davidkerny/Stadi_Speedo/PCB_Stadi_Speedo_V2/MEGA328PB Pinouttt.png

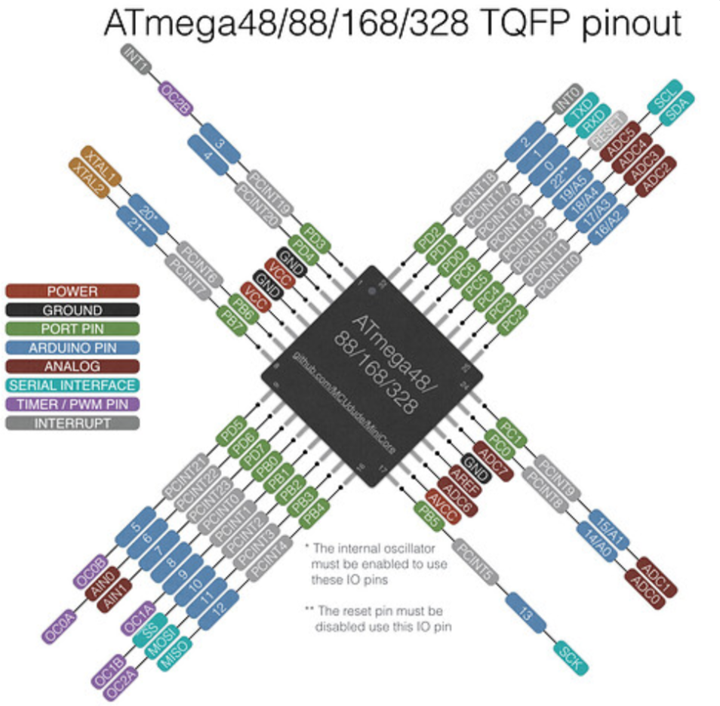
PCB_Stadi_Speedo_V2/MEGA328PB Pinouttt.png
