davidkerny/Stadi_Speedo/PCB_Stadi_Speedo_V2/PCB v2_zaloha 6_10/Screenshot_49.png

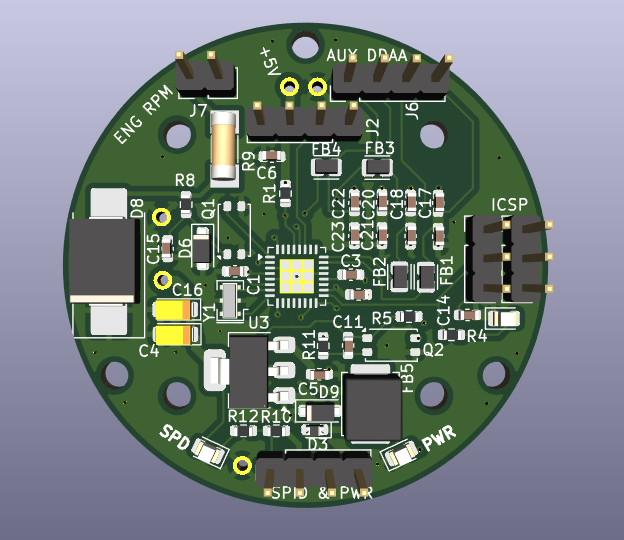
PCB_Stadi_Speedo_V2/PCB v2_zaloha 6_10/Screenshot_49.png
