davidkerny/Stadi_Speedo/README.md

Varianty pro Stadi_Speedo HW board:
__________________________________

MultiGauge od V1.8:

1. SPÍDO režim: (rychloměr) se ukazuje:
   pokud budík zaznamená jízdu.
   Pokud nějaké zaznamená, ukáže i celkově ujeté km, trip km, max. km/h, otáčky motoru.
   Při rychlejší jízdě radši skryje zbytečnosti.
3. TACHO režim (otáčkoměr)
   pokud zaznamenává otáčky motoru, ale ještě nikdy "nejel". Rpm + max. rpm.
4. Rev Mode (dočasný otáčkoměr)
   pokud už moped jel a tůruješ ho na místě, ukáže otáčky, max. rpm + trip km.

Historické okénko:
- Tacho V1 vychází ze Speedo V6
- MultiGauge V1 vychází ze Speedo V6 + Tacho V1
- AnaloGauge V1 vychází z MultiGauge V1.3

________________________
Varianty pro Waveshare ESP32-S3 2.1 TOUCH LCD board:

  - WS21 Gauge

_________________________
