davidkerny/Stadi_Speedo/grafika/Screenshot_43.png

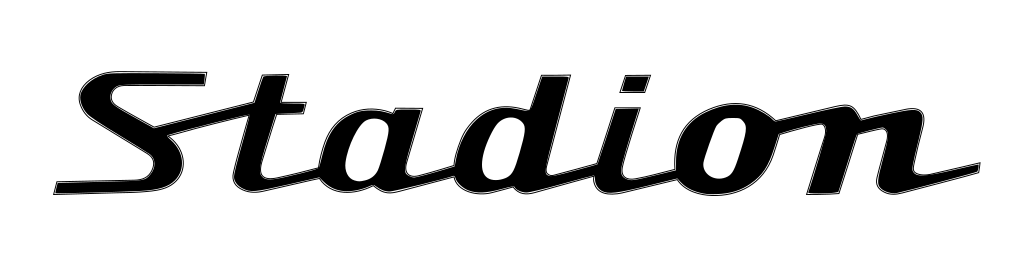
grafika/Screenshot_43.png
