davidkerny/Stadi_Speedo/PCB_AnaloGauge_UniFace/Screenshot_56.png

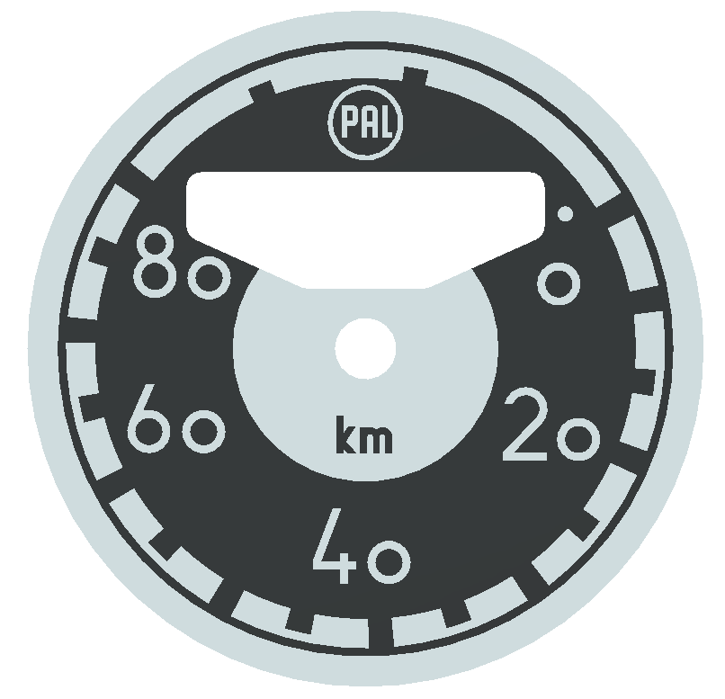
PCB_AnaloGauge_UniFace/Screenshot_56.png
