davidkerny/Stadi_Speedo/PCB_AnaloGauge_UniFace/Screenshot_57.png

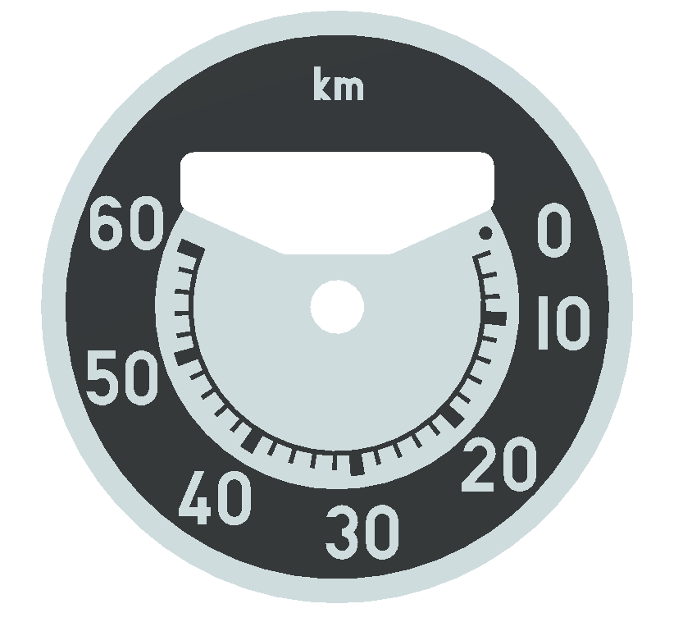
PCB_AnaloGauge_UniFace/Screenshot_57.png
