davidkerny/Stadi_Speedo/PCB_AnaloGauge_UniFace/Screenshot_58.png

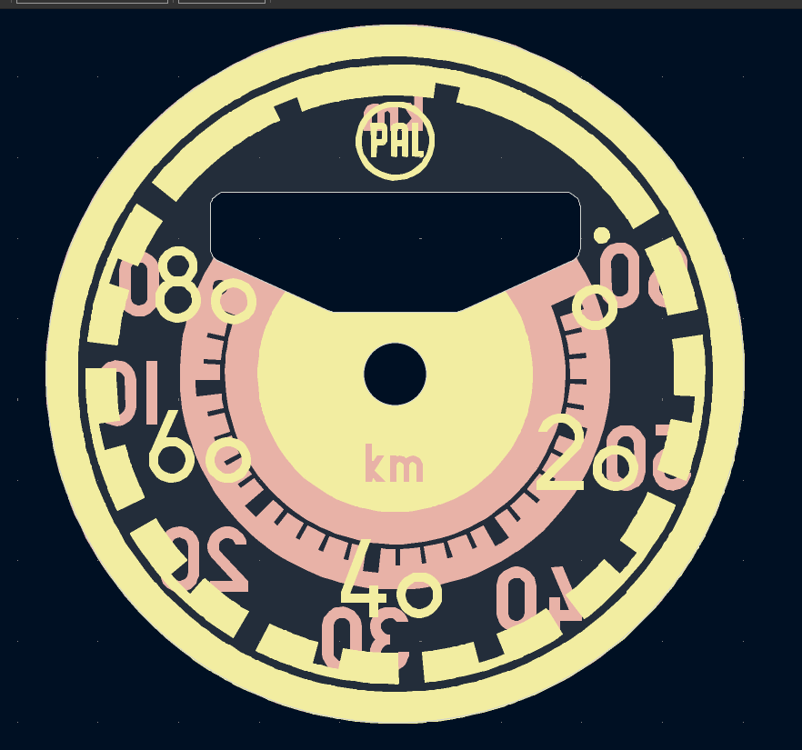
PCB_AnaloGauge_UniFace/Screenshot_58.png
