davidkerny/Stadi_Speedo/PCB_AnaloGauge_UniFace/Screenshot_60.png

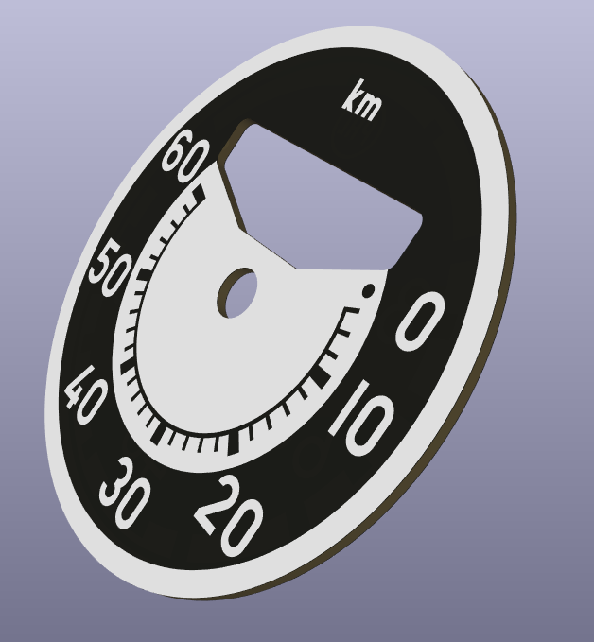
PCB_AnaloGauge_UniFace/Screenshot_60.png
