davidkerny/Stadi_Speedo/PCB_Stadi_Speedo_V2/Screenshot_57.png

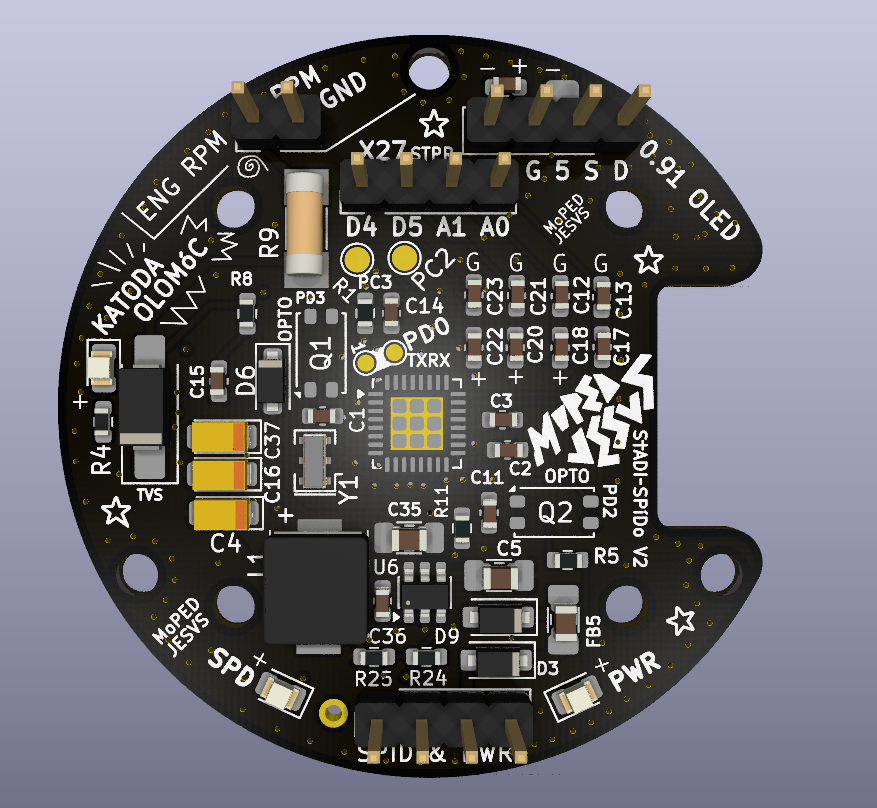
PCB_Stadi_Speedo_V2/Screenshot_57.png
