davidkerny/Stadi_Speedo/PCB_Stadi_Speedo_V2/Screenshot_58.png

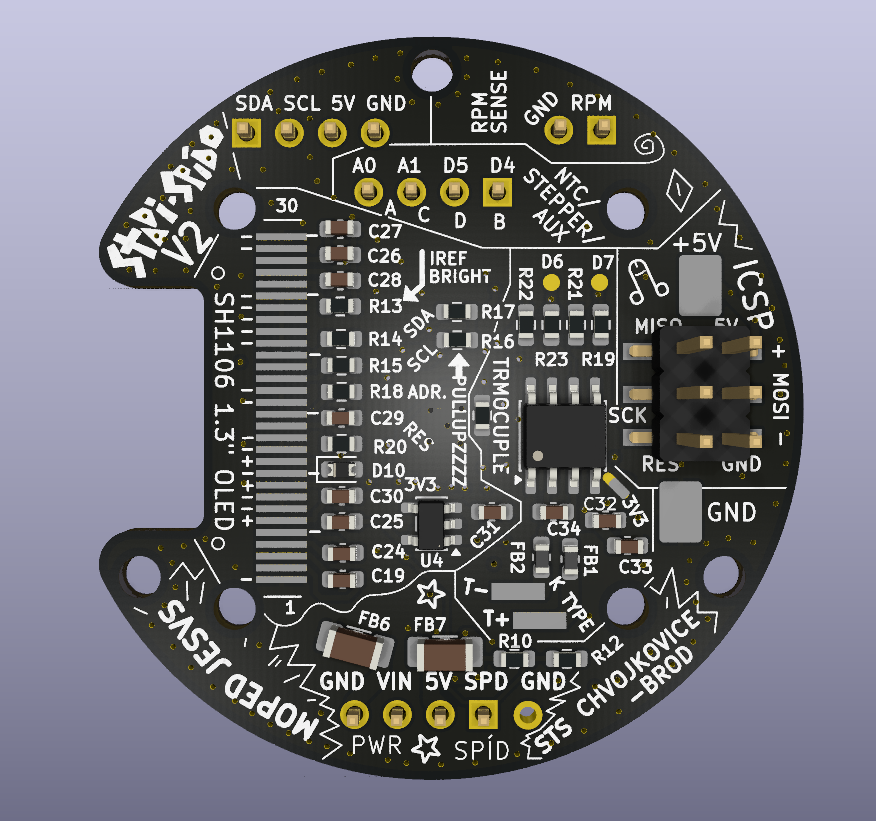
PCB_Stadi_Speedo_V2/Screenshot_58.png
