davidkerny/Stadi_Speedo/PCB_Stadi_Speedo_V2/webench lmr51610.png

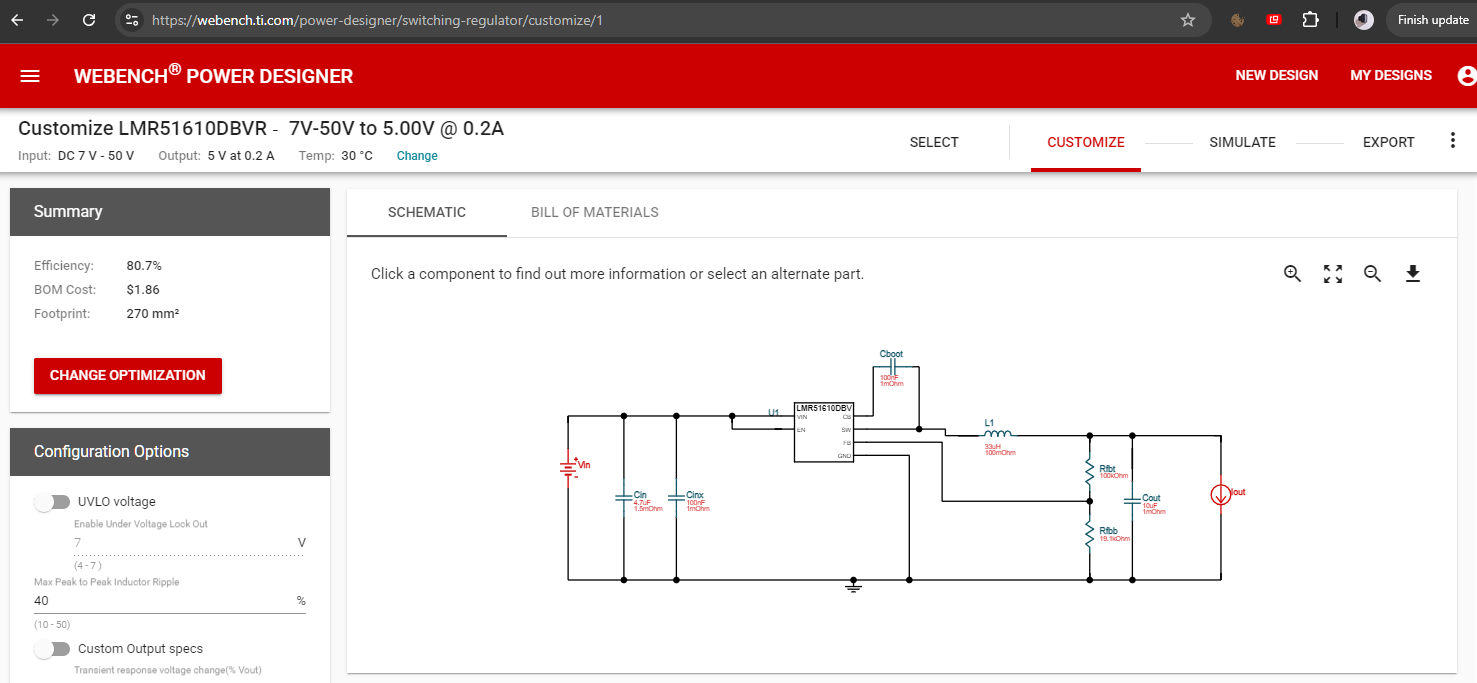
PCB_Stadi_Speedo_V2/webench lmr51610.png
