davidkerny/Stadi_Speedo/PCB_Stadi_Speedo_V2/bom/Stadi_Speedo_V2.csv

Id | Designator | Footprint | Quantity | Designation | Supplier and ref
1 | , , , , , , , , , , |  | 11
2 | C1, C2, C6, C19, C24, C25, C30, C31, C33 | C_0603_1608Metric | 9 | 1u
3 | C3, C11, C12, C13, C14, C17, C18, C20, C21, C22, C23, C29, C32, C34, C36 | C_0603_1608Metric | 15 | 100n
4 | C4, C16, C37 | CP_EIA-3216-10_Kemet-I | 3 | 4u7_16V
5 | C5 | C_0603-1206_universal_Pad1.18x1.45mm | 1 | 4u7
6 | C15 | C_0603_1608Metric | 1 | 10n
7 | C26, C27 | C_0603_1608Metric | 2 | 2.2u
8 | C28 | C_0603_1608Metric | 1 | 4.7u
9 | C35 | C_0603-1206_universal_Pad1.18x1.45mm | 1 | 4u7_16V
10 | D1, D7 | LED_0805_2012Metric | 2 | Yellow
11 | D2 | LED_0805_2012Metric | 1 | Green
12 | D3 | D_SOD-123FL | 1 | D_Small
13 | D6 | D_SOD-123F | 1 | 1N4148W
14 | D8 | D_SMA_Handsoldering | 1 | SMCJ85CA
15 | D9 | D_SOD-123FL | 1 | PTVS8V5S1UTR-QX
16 | D10 | D_0603_1608Metric | 1 | D_Small
17 | FB1, FB2 | L_0603_1608Metric | 2 | FerriteBead_Small
18 | FB5 | C_0603-1206_universal_Pad1.18x1.45mm | 1 | FerriteBead_4A_180Ω
19 | FB6, FB7 | C_0603-1206_universal_Pad1.33x1.80mm_HandSolder | 2 | FerriteBead_4A_180Ω
20 | J2 | PinHeader_1x04_P2.54mm_Vertical | 1 | OLED I2C
21 | J3 | PinHeader_2x03_P2.54mm_Vertical_SMD | 1 | ICSP
22 | J4 | OLED-128O064D | 1 | OLED SH1106
23 | J5 | PinHeader_1x04_P2.54mm_Vertical | 1 | SPÍD & PWR
24 | J6 | PinHeader_1x04_P2.54mm_Vertical | 1 | AUX DDAA
25 | J7 | PinHeader_1x02_P2.54mm_Vertical | 1 | ENG RPM
26 | L1 | L_Bourns_SRP2313AA | 1 | L_Ferrite
27 | Q1 | Panasonic_APV-AQY_SSOP-4_4.45x2.65mm_P1.27mm | 1 | 140817143200
28 | Q2 | Panasonic_APV-AQY_SSOP-4_4.45x2.65mm_P1.27mm | 1 | PC817
29 | R1, R4, R5, R12 | R_0603_1608Metric | 4 | 1k
30 | R8 | R_0603_1608Metric | 1 | 15k
31 | R9 | R_MELF_MMB-0207 | 1 | 200R
32 | R10 | R_0603_1608Metric | 1 | 10k
33 | R11 | R_0603_1608Metric | 1 | 470R
34 | R13 | R_0603_1608Metric | 1 | 560K (390K)
35 | R14, R15 | R_0603_1608Metric | 2 | 100R
36 | R16, R17, R20 | R_0603_1608Metric | 3 | 10k (4K7)
37 | R18 | R_0603_1608Metric | 1 | 4K7
38 | R19, R23, R23 | R_0603_1608Metric | 3 | 10K
39 | R21, R22 | R_0603_1608Metric | 2 | 20K
40 | R24 | R_0603_1608Metric | 1 | 100k
41 | R25 | R_0603_1608Metric | 1 | 19.1k
42 | U1 | QFN-32-1EP_5x5mm_P0.5mm_EP3.1x3.1mm | 1 | Mikroprofesor
43 | U4 | SOT-23-5 | 1 | ME6211C33M5
44 | U5 | SOIC-8_3.9x4.9mm_P1.27mm | 1 | MAX31855KASA
45 | U6 | SOT-23-6 | 1 | LMR51610YDBVR
46 | Y1 | Resonator_SMD_Murata_CSTxExxV-3Pin_3.0x1.1mm | 1 | 16MHz
