davidkerny/Stadi_Speedo/PCB_Stadi_Speedo_V2/production/Stadi_Speedo_V2_bom.csv

Designator | Footprint | Quantity | Value | LCSC Part #
_11, _10, _9, _8, _7, _6, _5, _4, _3, _2, |  | 11
C1, C19, C2, C24, C25, C30, C31, C33, C6 | 0603 | 9 | 1u
C11, C12, C13, C14, C17, C18, C20, C21, C22, C23, C29, C3, C32, C34, C36 | 0603 | 15 | 100n
C15 | 0603 | 1 | 10n
C16, C37, C4 | CP_EIA-3216-10_Kemet-I | 3 | 4u7_16V
C26, C27 | 0603 | 2 | 2.2u
C28 | 0603 | 1 | 4.7u
C35 | C_0603-1206_universal_Pad1.18x1.45mm | 1 | 4u7_16V
C5 | C_0603-1206_universal_Pad1.18x1.45mm | 1 | 4u7
D1, D7 | 0805 | 2 | Yellow | C2296
D10 | 0603 | 1 | D_Small
D2 | 0805 | 1 | Green | C2297
D3 | D_SOD-123FL | 1 | D_Small
D6 | D_SOD-123F | 1 | 1N4148W
D8 | D_SMA_Handsoldering | 1 | SMCJ85CA
D9 | D_SOD-123FL | 1 | PTVS8V5S1UTR-QX
FB1, FB2 | 0603 | 2 | FerriteBead_Small
FB5 | C_0603-1206_universal_Pad1.18x1.45mm | 1 | FerriteBead_4A_180Ω
FB6, FB7 | C_0603-1206_universal_Pad1.33x1.80mm_HandSolder | 2 | FerriteBead_4A_180Ω
J2 | PinHeader_1x04_P2.54mm_Vertical | 1 | OLED I2C
J3 | PinHeader_2x03_P2.54mm_Vertical_SMD | 1 | ICSP
J4 | OLED-128O064D | 1 | OLED SH1106
J5 | PinHeader_1x04_P2.54mm_Vertical | 1 | SPÍD & PWR
J6 | PinHeader_1x04_P2.54mm_Vertical | 1 | AUX DDAA
J7 | PinHeader_1x02_P2.54mm_Vertical | 1 | ENG RPM
L1 | L_Bourns_SRP2313AA | 1 | L_Ferrite
Q1 | Panasonic_APV-AQY_SSOP-4_4.45x2.65mm_P1.27mm | 1 | 140817143200
Q2 | Panasonic_APV-AQY_SSOP-4_4.45x2.65mm_P1.27mm | 1 | PC817
R1, R12, R4, R5 | 0603 | 4 | 1k
R10, R19, R23_2, R23 | 0603 | 4 | 10k
R11 | 0603 | 1 | 470R
R13 | 0603 | 1 | 560K (390K)
R14, R15 | 0603 | 2 | 100R
R16, R17, R20 | 0603 | 3 | 10k (4K7)
R18 | 0603 | 1 | 4K7
R21, R22 | 0603 | 2 | 20K
R24 | 0603 | 1 | 100k
R25 | 0603 | 1 | 19.1k
R8 | 0603 | 1 | 15k
R9 | R_MELF_MMB-0207 | 1 | 200R
U1 | QFN-32-1EP_5x5mm_P0.5mm_EP3.1x3.1mm | 1 | Mikroprofesor
U4 | SOT-23-5 | 1 | ME6211C33M5
U5 | SOIC-8_3.9x4.9mm_P1.27mm | 1 | MAX31855KASA
U6 | SOT-23-6 | 1 | LMR51610YDBVR
Y1 | Resonator_SMD_Murata_CSTxExxV-3Pin_3.0x1.1mm | 1 | 16MHz
