davidkerny/Stadi_Speedo/PCB_AnaloGauge_UniFace/Stadi Dial.dxf

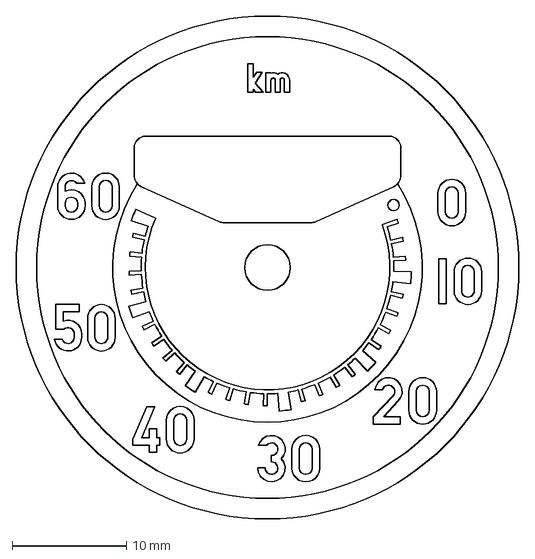
[picture p11: CAD file, 2026-10-29]
PCB_AnaloGauge_UniFace/Stadi Dial.dxf
44.0 x 44.0 mm
