davidkerny/Stadi_Speedo/PCB_Speedo_UniFace/Fichtl Dial V2.dxf

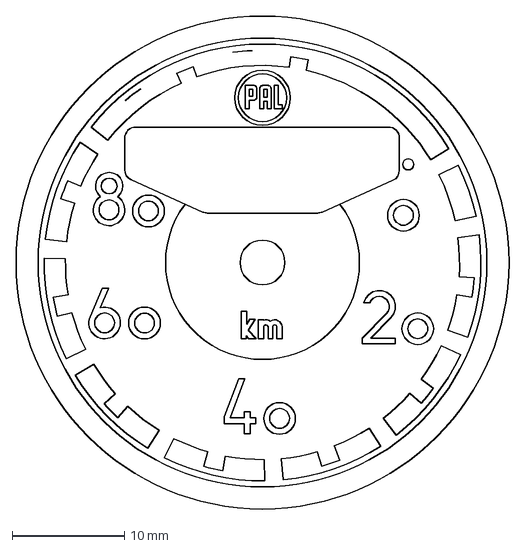
[picture p12: CAD file, 2026-10-13]
PCB_Speedo_UniFace/Fichtl Dial V2.dxf
44.0 x 44.0 mm
