davidkerny/Stadi_Speedo/PCB_Stadi_Speedo_V2/PCB Base V2.dxf

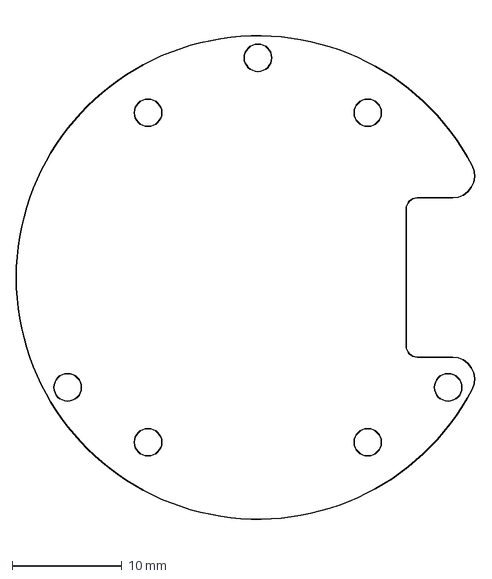
[picture p13: CAD file, 2026-10-08]
PCB_Stadi_Speedo_V2/PCB Base V2.dxf
41.8 x 47.6 mm
