davidkerny/Stadi_Speedo/PCB_Stadi_Speedo_V2/PCB v2_zaloha 6_10/stadi speedo board holes layout.dxf

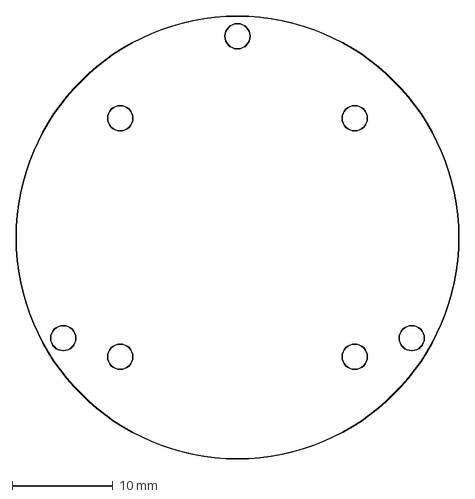
[picture p14: CAD file, 2026-07-02]
PCB_Stadi_Speedo_V2/PCB v2_zaloha 6_10/stadi speedo board holes layout.dxf
44.0 x 44.0 mm
