davidkerny/Stadi_Speedo/PCB_AnaloGauge_UniFace/Fichtl_Dial_white.dxf

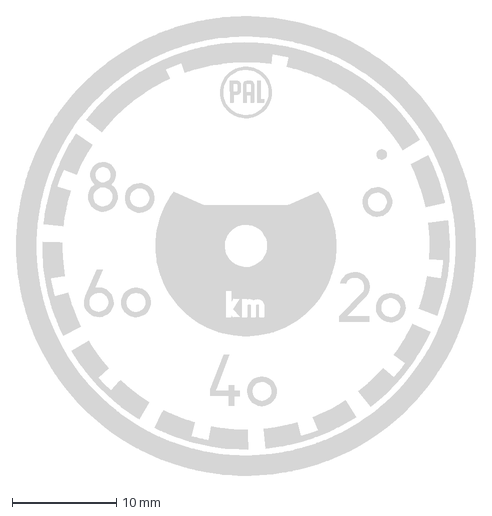
[picture p15: CAD file, 2026-10-29]
PCB_AnaloGauge_UniFace/Fichtl_Dial_white.dxf
44.0 x 44.0 mm
