davidkerny/Stadi_Speedo/PCB_Speedo_UniFace/dials V2.stl

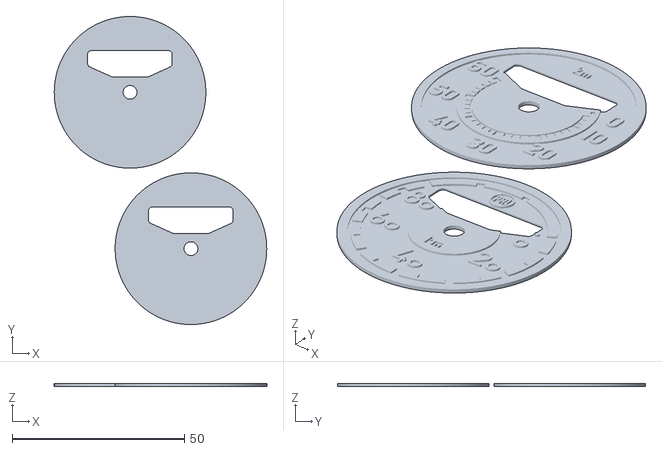
[picture p16: CAD file, 2026-10-13]
PCB_Speedo_UniFace/dials V2.stl
61.7 x 89.4 x 0.8
