davidkerny/Stadi_Speedo/PCB_AnaloGauge_UniFace/Fichtl Dial.dxf

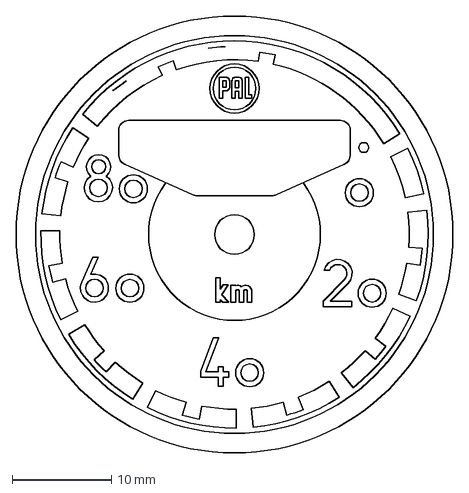
[picture p17: CAD file, 2026-10-29]
PCB_AnaloGauge_UniFace/Fichtl Dial.dxf
44.0 x 44.0 mm
