davidkerny/Stadi_Speedo/PCB_Speedo_UniFace/fichtl dial.stl

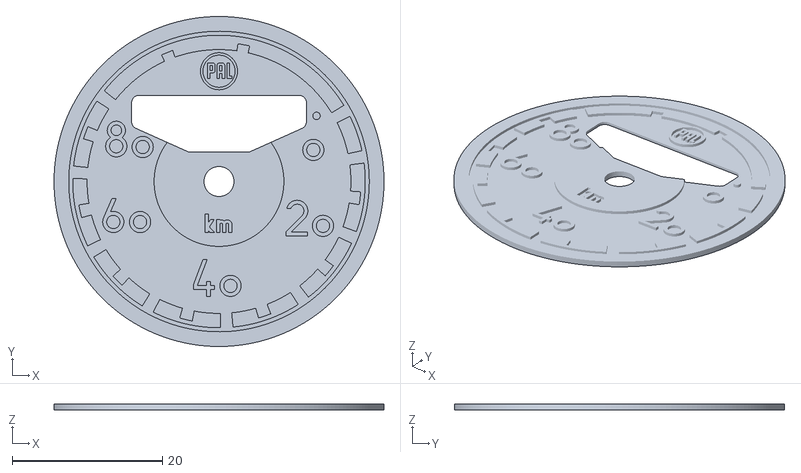
[picture p18: CAD file, 2026-10-11]
PCB_Speedo_UniFace/fichtl dial.stl
44.0 x 44.0 x 0.8
