davidkerny/Stadi_Speedo/PCB_AnaloGauge_UniFace/Fichtl_Dial_white_polylines.dxf

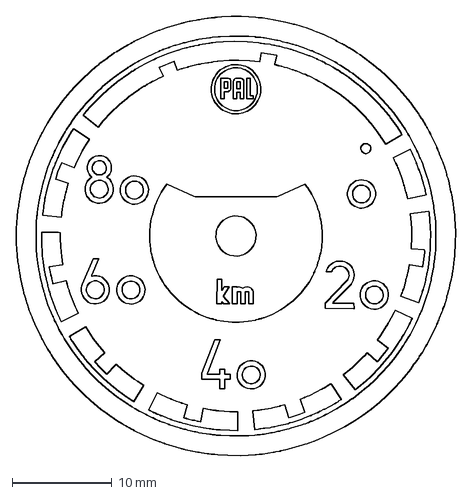
[picture p19: CAD file, 2026-10-29]
PCB_AnaloGauge_UniFace/Fichtl_Dial_white_polylines.dxf
44.0 x 44.0 mm
