davidkerny/Stadi_Speedo/PCB_Speedo_UniFace/Fichtl_Dial_white (1).dxf

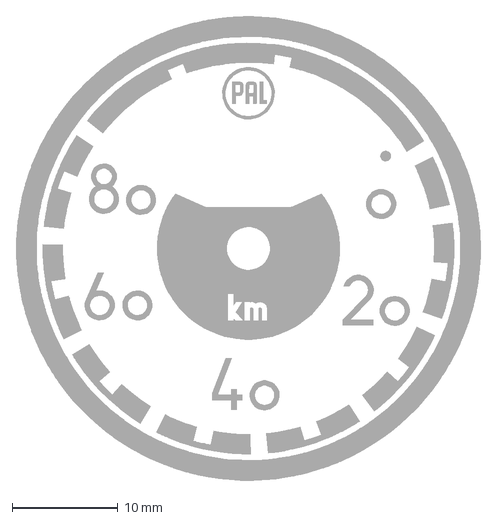
[picture p20: CAD file, 2026-10-08]
PCB_Speedo_UniFace/Fichtl_Dial_white (1).dxf
44.0 x 44.0 mm
