davidkerny/Stadi_Speedo/(list of files, cad)

Other CAD files:
PCB_Speedo_UniFace/stadi dial.stl
