davidkerny/Stadi_Speedo/Stadi_MultiGauge/changelog.txt

*MULTIGAUGE CHANGELOG*
________________________________________________________

v2.1	Debug: počítadlo neúspěšných EEPROM zápisů kvůli low voltage.
		výpis napětí na displeji
	Low Voltage Flag / Hnědý poplach; po neúspěšném zápisu do EEPROM se zobrazí tečka v levém horním rohu displeje

v2.0	možná Spása: I2C TIMEOUT !!! upravená Wire knihovna: zamrzlé I2C se obnovuje bez nutnosti resetu
	Debug Mode; ukazuje na spodku displeě počet I2C fixů a resetů, pokud nějaké byly.

Sketch uses 28814 bytes (88%) of program storage space. Maximum is 32384 bytes.
Global variables use 962 bytes (46%) of dynamic memory, leaving 1086 bytes for local variables.

v1.99	nic nového

v1.85	Dolazení módů: Spído mode, Tacho mode a RevMode
	úklid na displeji i v kódu.
	Multigauge de facto nahrazuje i Tacho.

Sketch uses 26784 bytes (82%) of program storage space. Maximum is 32384 bytes.
Global variables use 932 bytes (45%) of dynamic memory, leaving 1116 bytes for local variables. Maximum is 2048

v1.8	Přidán RPM mode, který ukazuje jen RPM, když nečtem otáčky
	úklid na displeji
	TopRPM

v1.7	FIXED; Šetříme RAM
	- displej používá page buffer (_2_) místo celého (_F_)  -> cca -770 B
	- texty ve flash (PROGMEM / F())
	- trip bez floatu a dtostrf

v1.63
	při resetu se nezobrazuje welcome logo, ale rovnou navážeme. welcome logo jen při studeném startu.
Sketch uses 25356 bytes (78%) of program storage space. Maximum is 32384 bytes.
Global variables use 1763 bytes (86%) of dynamic memory, leaving 285 bytes for local variables.
!!!!!!!!!!!!!!!!!!!!!!!STACK OVERFLOW!!!!!!!!! funguje na 328P nefunguje na 328PB!!!!!!!!!!

v1.62
	reorganizace LCD; trip se zobrazuje stále, když nečteme RPM, vpravo nápis km/h a TOPSPEED, aka uklizeno za všech podmínek
	Multigauge de facto nahrazuje i Speedo.

v1.61
	TOP Speed, retained v RAM jako TRIPmetr, zobrazené při stání v levém hornim rohu, pokud už se něco zaznamenalo.
	RPM se zobrazují jen když nějaké čteme

v1.6
	Zachování obsahu RAM po resetu za jízdy. (TRIP metr) kontrola validity RAM skrze magic number. Po delší odstávce jede TRIP od nuly

v1.53
	- MAX_ZMENA_RYCHLOSTI_KMH_ZA_S = 120.0 - Když watchdog za jízdy zresetuje budík, je potřeba z nuly naběhnout na aktuální rychlost
	- MAX_SKOK_KMH = 120.0;  vypnuto taky

v1.52 
	- tuning fyzických rozměrů kola, drobný úklid

v1.5
	 - oprava logiky sběru pulzů speeda - započítávají se všechny pulzy včetně invalidovaných. 
	jinak se stávalo, že se občas při akceleraci speedo zasekne na 10 nebo 16 km/h a za jízdy zůstane, až do zastavení.

	nová const float MAX_ZMENA_RYCHLOSTI_KMH_ZA_S = 60.0;
	 // Fyzikální strop na zrychlení/zpomalení (km/h za vteřinu).
	 // Nastaveno benevolentně, protože moped umí zrychlovat kurevsky.
	 // Chrání proti periodickému/korelovanému rušení, které dokáže
	 // "souhlasit samo se sebou" napříč více pulzy, ale nedokáže
	 // obelhat fyziku (čas mezi pulzy).

Sketch uses 24890 bytes (76%) of program storage space. Maximum is 32384 bytes.
Global variables use 1751 bytes (85%) of dynamic memory. Odhadovaná potřeba ~150 B

V1.4 
	- Watchdog spuštěn už na začátku setupu, nutno 
	vyzkoušet jeslti nebude timeoutovat při běžném provozu
	- I2C timeout nejde udělat. tak aspoň "odseknutí", I2C BUS CLEAR devíti pulzy
	- během loga 8x blikne LED, pro rozlišení od blikání heartbeatu

V1.3 Initial

______________________________________

Pinout
2   PD2   SPIDO
3   PD3   TACHO
13  PB5   LED, SCK
A0  PC0   X27 A  nebo AUX
4   PD4   X27 B  nebo AUX
A1  PC1   X27 C  nebo AUX
5   PD5   X27 D  nebo AUX

11  PB3 MOSI
12  PB4 MISO

18/A4 PC4 SDA
19/A5 PC5 SCL
