davidkerny/Stadi_Speedo/Stadi_ThermoGauge/Thermo_changelog.txt

Stadi Thermo Changelog
________________________

0.32 issue: teplota cpu stále driftuje dolu, řidší vyčítání nepomohlo

0.3 opravy znaménka stupňů a tak
