davidkerny/Stadi_Speedo/PCB_Stadi_Speedo_V2/Stadi_Speedo_V2.kicad_pcb

## KiCad design PCB_Stadi_Speedo_V2/Stadi_Speedo_V2.kicad_pcb (2026-10-29)

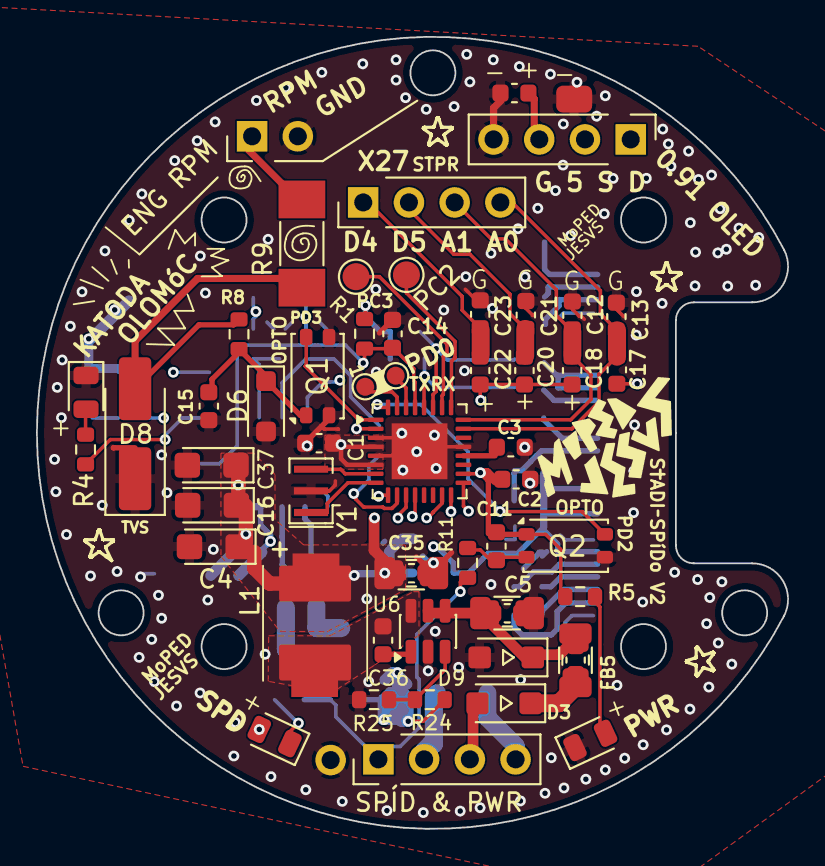
[picture p21: board Stadi_Speedo_V2.kicad_pcb from above]

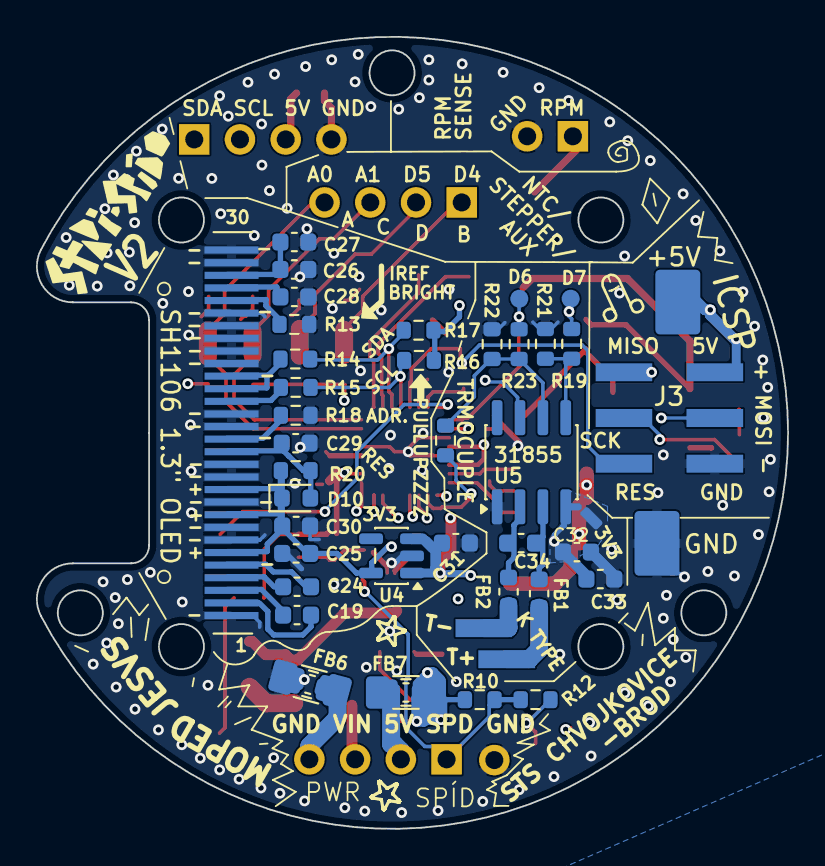
[picture p22: board Stadi_Speedo_V2.kicad_pcb from below]

Board: 4 copper layers, 41.7 x 44.0 mm, 86 parts (35 on the bottom side), 56 nets.

Parts:
C1, C2, C6, C19, C24, C25, C30, C31, C33: 1u; C_0603_1608Metric
C3, C11, C12, C13, C14, C17, C18, C20, C21, C22, C23, C29, C32, C34, C36: 100n; C_0603_1608Metric
C4, C16, C37: 4u7_16V; CP_EIA-3216-10_Kemet-I
C5: 4u7; C_0603-1206_universal_Pad1.18x1.45mm
C15: 10n; C_0603_1608Metric
C26, C27: 2.2u; C_0603_1608Metric
C28: 4.7u; C_0603_1608Metric
C35: 4u7_16V; C_0603-1206_universal_Pad1.18x1.45mm
D1, D7: Yellow; LED_0805_2012Metric
D2: Green; LED_0805_2012Metric
D3: D_Small; D_SOD-123FL
D6: 1N4148W; D_SOD-123F
D8: SMCJ85CA; D_SMA_Handsoldering
D9: PTVS8V5S1UTR-QX; D_SOD-123FL
D10: D_Small; D_0603_1608Metric
FB1, FB2: FerriteBead_Small; L_0603_1608Metric
FB5: FerriteBead_4A_180Ω; C_0603-1206_universal_Pad1.18x1.45mm
FB6, FB7: FerriteBead_4A_180Ω; C_0603-1206_universal_Pad1.33x1.80mm_HandSolder
J2: OLED I2C; PinHeader_1x04_P2.54mm_Vertical
J3: ICSP; PinHeader_2x03_P2.54mm_Vertical_SMD
J4: OLED SH1106; OLED-128O064D
J5: SPÍD & PWR; PinHeader_1x04_P2.54mm_Vertical
J6: AUX DDAA; PinHeader_1x04_P2.54mm_Vertical
J7: ENG RPM; PinHeader_1x02_P2.54mm_Vertical
L1: L_Ferrite; L_Bourns_SRP2313AA
Q1: 140817143200; Panasonic_APV-AQY_SSOP-4_4.45x2.65mm_P1.27mm
Q2: PC817; Panasonic_APV-AQY_SSOP-4_4.45x2.65mm_P1.27mm
R1, R4, R5, R12: 1k; R_0603_1608Metric
R8: 15k; R_0603_1608Metric
R9: 200R; R_MELF_MMB-0207
R10: 10k; R_0603_1608Metric
R11: 470R; R_0603_1608Metric
R13: 560K (390K); R_0603_1608Metric
R14, R15: 100R; R_0603_1608Metric
R16, R17, R20: 10k (4K7); R_0603_1608Metric
R18: 4K7; R_0603_1608Metric
R19, R23, R23#2: 10K; R_0603_1608Metric
R21, R22: 20K; R_0603_1608Metric
R24: 100k; R_0603_1608Metric
R25: 19.1k; R_0603_1608Metric
TP3, TP4: Label; TestPoint_Pad_D1.5mm
TP5, TP6: Label; TestPoint_Pad_D1.0mm
U1: Mikroprofesor; QFN-32-1EP_5x5mm_P0.5mm_EP3.1x3.1mm
U4: ME6211C33M5; SOT-23-5
U5: MAX31855KASA; SOIC-8_3.9x4.9mm_P1.27mm
U6: LMR51610YDBVR; SOT-23-6
Y1: 16MHz; Resonator_SMD_Murata_CSTxExxV-3Pin_3.0x1.1mm

Connections:
+3V3: C25.2, C30.2, C32.2, C33.2, D10.1 (K), J4.6, J4.9, J4.11, R20.2, U4.5 (V_{OUT}), U5.4 (V_{CC})
+5V: C1.1, C2.1, C4.1, C6.1, C11.1, C16.1, C17.1, C18.1, C20.1, C22.1, C31.2, C35.1, C37.1, D7.2 (A), FB7.1, J2.3, J3.2, L1.2, Q2.1, R1.2, R5.1, R10.2, R16.1, R17.2, R24.2, U1.4 (VCC), U1.6 (VCC), U1.18 (AVCC), U4.1 (V_{IN}), U4.3 (CE)
/A0: C13.1, C17.2, J6.4, U1.23 (PC0)
/A1: C12.1, C18.2, J6.3, U1.24 (PC1)
/ADDR: J4.15, R18.2
/D2_SPD: J5.1, R10.1, R11.2, R12.1
/D3_ENG_RPM: J7.1, R9.1
/D3_ENG_RPM_ISOL: Q1.4, U1.1 (PD3)
/D4: C22.2, C23.1, J6.1, U1.2 (PD4)
/D5: C20.2, C21.1, J6.2, U1.9 (PD5)
/D6/CS K: R23.2, R23#2.2, U1.10 (PD6)
/D7/SCK K: R19.2, U1.11 (PD7)
/D8/SO K: U1.12 (PB0), U5.7 (SO)
/D11/MOSI_: J3.4, U1.15 (PB3)
/D12/MISO_: J3.1, U1.16 (PB4)
/D13/SCK_: J3.3, R4.1, U1.17 (PB5)
/I2C_SCL: J2.2, R15.1, R16.2, U1.28 (PC5)
/I2C_SDA: J2.1, R14.1, R17.1, U1.27 (PC4)
/IREF BRIGHTNESS: J4.26, R13.2
/OLED RES: C29.2, D10.2 (A), J4.14, R20.1
/OLED SCLK: J4.18, R15.2
/OLED SDA: J4.19, J4.20, R14.2
/OLED VCC: C26.2, C27.2, J4.28
/PD0: TP5.1 (1_1), U1.30 (PD0)
/PD1: TP6.1 (1_1), U1.31 (PD1)
/RESET_: C14.1, J3.5, R1.1, U1.29 (~RESET/PC6)
/XTAL1: U1.7 (XTAL1/PB6), Y1.3
/XTAL2: U1.8 (XTAL2/PB7), Y1.1
/sw: C36.2, L1.1, U6.6 (SW)
GND: C1.2, C2.2, C3.2, C4.2, C5.2, C6.2, C12.2, C13.2, C14.2, C15.2, C16.2, C21.2, C23.2, C25.1, C26.1, C27.1, C28.1, C29.1, C30.1, C31.1, C32.1, C33.1, C35.2, C37.2, D1.1 (K), D2.1 (K), D6.2 (A), D8.1 (A1), D9.2 (A), FB6.1, J2.4, J3.6, J4.1, J4.7, J4.8, J4.10, J4.12, J4.13, J4.16, J4.17, J4.21, J4.22, J4.23, J4.24, J4.25, J4.29, J4.30, J7.2, Q1.2, Q1.3, Q2.3, R13.1, R18.1, R21.1, R22.1, R25.1, U1.3 (GND), U1.5 (GND), U1.21 (GND), U1.33 (GND), U4.2 (V_{SS}), U5.1 (GND), U6.2 (GND), Y1.2
unnamed: C11.2, Q2.2, R11.1
unnamed: D1.2 (A), R4.2
unnamed: D2.2 (A), R5.2
unnamed: C15.1, D6.1 (K), Q1.1, R8.1
unnamed: D7.1 (K), R12.2
unnamed: D8.2 (A2), R8.2, R9.2
unnamed: C5.1, D9.1 (K), FB5.2, U6.4 (EN), U6.5 (VIN)
unnamed: C19.2, J4.2
unnamed: C19.1, J4.3
unnamed: C24.2, J4.4
unnamed: C24.1, J4.5
unnamed: C28.2, J4.27
unnamed: FB7.2, J5.2
unnamed: FB6.2, J5.4
unnamed: C3.1, U1.20 (AREF)
unnamed: TP4.1 (1_1), U1.25 (PC2)
unnamed: TP3.1 (1_1), U1.26 (PC3)
unnamed: Q2.4, U1.32 (PD2)
unnamed: R19.1, R21.2, U5.5 (SCK)
unnamed: C34.2, FB1.2, U5.3 (T+)
unnamed: C34.1, FB2.2, U5.2 (T-)
unnamed: R22.2, R23.1, R23#2.1, U5.6 (~CS)
unnamed: C36.1, U6.1 (CB)
unnamed: R24.1, R25.2, U6.3 (FB)
VBUS: D3.2 (A), J5.3
VCC: D3.1 (K), FB5.1
