davidkerny/Stadi_Speedo/Stadi_MultiGauge/Stadi_MultiGauge.ino

#include <Arduino.h>
#include <Wire.h>  // upravena s timeoutem
//  je potreba mit zapnuty #define WIRE_TIMEOUT 
//  v C:\Users\**\AppData\Local\Arduino15\packages\MiniCore\hardware\avr\3.1.3\libraries\Wire\src\Wire_timeout.h
#include "U8g2lib.h"
#include <EEPROM.h>
#include <avr/wdt.h>
#include <avr/interrupt.h>
#include "stadionlogo.h"

// ============================================================

// Texty v PROGMEM = leží ve flash
const char FW_VERZE[] PROGMEM =" Stadi MultiGauge 2.11";

//  Speedo čte kolo na D2. = KM/H
//  Tacho  čte otáčky motoru na D3 = RPM
//  ODOmetr je v EEPROM. TRIP, TopRychlost a TopRPM v RAM.
//  Inteligentní zobrazení podle relevance.
//  v Debug mode počítá: I2C errory, Resety, hnědé poplachy a napětí na MCU.
//
//  Ochrana proti rušení, falešným pulzům, zamrznutí procesoru, rozbití I2C komunikace, 
//  Ochrana EEPROM proti korupci, obnovení dat z RAM po resetu
//
// ============================================================

// 1) NASTAVENÍ
// 2) STAV PROGRAMU
// 3) MĚŘENÍ NAPÁJENÍ (Vcc)
// 4) EEPROM - ukládání ODO
// 5) PŘERUŠENÍ - SPEEDO
// 6) PŘERUŠENÍ - TACHO
// 7) FILTR SPEEDA
// 8) FILTR TACHA
// 9A) HEARTBEAT LED (diagnostika, D13)
// 9B) ÚVODNÍ LOGO
// 9C) I2C FIX / BUS CLEAR (HAJZLZVON)
// 10) HLAVNÍ SMYČKA - SETUP
// 11) ZPRACOVÁNÍ SPEEDA
// 12) ZPRACOVÁNÍ TACHA
// 13) KONTROLA ZASTAVENÍ SPEEDA
// 14) KONTROLA ZASTAVENÍ TACHA
// 15) LOOP
// 16) DISPLEJ
//  16.1) VÝPOČTY A LOGIKA REŽIMŮ (PŘED KRESLENÍM)
//  16.2) KRESLENÍ
//  16.4) LAYOUT B: SPÍDO
//  16.3) LAYOUT A: TACHO aka RevMode

// ============================================================
// 1) NASTAVENÍ
// ============================================================

// --- TESTOVACÍ NÁSOBIČ (pro finální provoz změň na 1) ---
#define TEST_MULTIPLIER 1

// --- DEBUG: výpis čítačů I2C/WDT na displeji (pro finální provoz zakomentuj) ---
#define DEBUG_MODE

// --- OLED init ---
// POZOR: "_2_" místo "_F_" = page buffer (256 B). Kreslení MUSÍ být v firstPage()/nextPage().
U8G2_SSD1306_128X64_NONAME_2_HW_I2C u8g2(U8G2_R0, U8X8_PIN_NONE);//Klasika 0.96"
//U8G2_SH1106_128X64_NONAME_2_HW_I2C u8g2(U8G2_R0, U8X8_PIN_NONE); //Laskakit 1.3"
//U8G2_SSD1306_128X32_UNIVISION_2_HW_I2C u8g2(U8G2_R0, U8X8_PIN_NONE); //Placatej zmrd 0.91"

// --- SPEEDO snímač kola (INT0) ---
const byte SENSOR_PIN = 2;

// Obvod kola v metrech. = vzdálenost per pulz
const float OBVOD_KOLA_M = 1.74;    //16" kolo, guma terénní 16x2.75 FICHTL / SIMSON
//const float OBVOD_KOLA_M = 1.86;  //19" kolo, guma 19x2.25 STADION

// --- SPEEDO tuning ---
const unsigned long MIN_MEZERA_PULZU_US = 45000UL; // do 120 km/h. Rychlejší pulz ignorujem.
const float MAX_ROZUMNA_RYCHLOST_KMH = 120.0;
const float MAX_SKOK_KMH = 120.0; // mezi pulzy - vypnuto
const float MAX_ROZDIL_SOUSEDNICH_PULZU_KMH = 8.0;
const float MAX_ZMENA_RYCHLOSTI_KMH_ZA_S = 120.0;  // vypnuto
const unsigned long CAS_DO_ZASTAVENI_MS = 2000UL;
const float KALMAN_Q = 0.5;
const float KALMAN_R = 8.0;

// --- TACHO snímač motor rpm (INT1) ---
const byte TACHO_PIN = 3; // ducati energia simson

// --- TACHO tuning ---
// const unsigned long MIN_MEZERA_TACHO_US = 2800UL; v případě 1pulz=1ot.
const unsigned long MIN_MEZERA_TACHO_US = 1333UL; // (15Krpm 3pulz/ot)
const float PULZY_NA_OTACKU = 3.0;  // Tacho pulzy per otáčka: ZAPALKO DUCATI ENERGIA
const float MAX_ROZUMNE_RPM = 15000.0;
const float MIN_ROZUMNE_RPM = 500.0;
const float MAX_SKOK_RPM = 7000.0; // benevolentnější měření
const float MAX_ROZDIL_SOUSEDNICH_PULZU_RPM = 2500.0; // benevolentnější měření
const unsigned long CAS_DO_ZASTAVENI_TACHO_MS = 200UL; // Když 200 ms nic nepřijde, motor chcípl.
const float TACHO_KALMAN_Q = 2.0; // Vyšší Q = rychlejší reakce na vrknutí plynem.
const float TACHO_KALMAN_R = 8.0;

// --- Welcome logo ---
const unsigned long LOGO_DOBA_ZOBRAZENI_MS = 1500UL;
const byte LOGO_POCET_BLIKNUTI = 8;

// --- EEPROM / ODO ---
const int ODO_ADR_START = 0;
const int ODO_ADR_KONEC = 252;
const unsigned long KROK_ULOZENI_M = 100UL;
const unsigned long ODO_FYZICKY_STROP_M = 100000000UL;
const unsigned long ODO_MAX_SKOK_MEZI_BUNKAMI_M = 1000000UL;
#define KONTROLA_NAPETI_ZAPNUTA 1
const long MIN_VCC_PRO_ZAPIS_MV = 3400L;

// --- Displej ---
const unsigned long DISPLEJ_INTERVAL_MS = 100;
const unsigned long I2C_TIMEOUT_US = 10000UL;  // max čekání na jednu I2C operaci (10 ms)


// ============================================================
// 2) STAV PROGRAMU
// ============================================================

// -- Ujetá vzdálenost --
unsigned long odoMetry = 0;

// TRIP, TopRychlost a TopRPM + magic number leží v .noinit -> startup kód je při resetu
// nenuluje. Při studeném startu v nich je náhodný obsah.
unsigned long tripMetry __attribute__((section(".noinit")));
unsigned long tripMagic __attribute__((section(".noinit")));
unsigned int topRychlostKmh __attribute__((section(".noinit")));
unsigned int topRpm __attribute__((section(".noinit")));

// -- Aktuální rychlost Speedo--
unsigned int zobrazenaRychlostKmh = 0;

// -- Aktuální otáčky Tacho --
unsigned int zobrazeneRpm = 0;
bool rezimOtackomeru = false; // Režim otáčkoměru na začátku vypnutý

// -- Kalman speedo --
float kalman_x = 0;
float kalman_p = 1;

// -- Pomoc speeda s rušením --
float posledniSurovaRychlostKmh = 0.0;
bool mamePredchoziPulz = false;
bool jsmeVPohybu = false;

// Čas posledního zpracovaného pulzu (přijatého i zamítnutého) -
// potřeba pro výpočet implikovaného zrychlení/zpomalení mezi
// dvěma po sobě jdoucími pulzy.
unsigned long casPoslednihoZpracovanehoPulzuUs = 0;

// -- Kalman tacho --
float tachoKalman_x = 0;
float tachoKalman_p = 1;

// -- Pomoc tacha s rušením --
float posledniSuroveRpm = 0.0;
bool tachoMamePredchoziPulz = false;
bool motorBezi = false;

// -- EEPROM housekeeping --
int odoAdresaAktualni = ODO_ADR_START;
unsigned long odoNaposledyUlozeno = 0;
long posledniZmereneVccMv = 0; // v mV, např. 4200 = 4.2V, 0 = ještě se neměřilo
bool nizkeNapeti = false; // tečka, indikátor nízkého napětí

// -- Časování displeje --
unsigned long displejNaposledyCas = 0;

// -- Sdílené se speedo ISR --
volatile unsigned long speedoIsrCasPoslednihoPulzuUs = 0;
volatile unsigned long speedoIsrDelkaPoslednihoIntervaluUs = 0;
volatile bool speedoIsrMameNovyPulz = false;

// -- Sdílené s tacho ISR --
volatile unsigned long tachoIsrCasPoslednihoPulzuUs = 0;
volatile unsigned long tachoIsrDelkaPoslednihoIntervaluUs = 0;
volatile bool tachoIsrMameNovyPulz = false;

// -- Heartbeat LED (diagnostika, D13) --
volatile uint8_t heartbeatPocitadloPreruseni = 0;

// -- DEBUG MODE: I2C FIX & WDT --
#ifdef DEBUG_MODE
unsigned long i2cTimeoutPocet __attribute__((section(".noinit")));  // I2C timeouty zotavené bez resetu
unsigned int resetPocet __attribute__((section(".noinit")));        // resety za provozu (RAM přežila)
unsigned long eepromNapetiPocet __attribute__((section(".noinit"))); // ODO se nezapsalo kvůli nízkému Vcc
#endif

// ============================================================
// 3) MĚŘENÍ NAPÁJENÍ (Vcc)
// ============================================================

#if KONTROLA_NAPETI_ZAPNUTA
long nactiNapetiVcc()
{  // Na 328PB čteme interní bandgap vůči Vcc.
  ADCSRB &= ~(1 << 5);
  ADMUX = _BV(REFS0) | _BV(MUX3) | _BV(MUX2) | _BV(MUX1);
  delayMicroseconds(500);
  ADCSRA |= _BV(ADSC);
  while (bit_is_set(ADCSRA, ADSC));
  uint16_t vysledekAdc = ADC;
  const long VCC_KALIBRACNI_KONSTANTA = 1125300L;
  return VCC_KALIBRACNI_KONSTANTA / vysledekAdc;}
#endif

// ============================================================
// 4) EEPROM a RAM - ukládání ODO, TRIP, topRpm
// ============================================================

void nactiOdoZEEPROM()
{  unsigned long nejvyssiPlatnaHodnota = 0;
  int adresaSNejvyssiHodnotou = ODO_ADR_START;
  for (int adr = ODO_ADR_START; adr <= ODO_ADR_KONEC; adr += 4)
  { unsigned long hodnota = 0;
    EEPROM.get(adr, hodnota);
    if (hodnota == 0xFFFFFFFFUL) continue;
    if (hodnota > ODO_FYZICKY_STROP_M) continue;
    bool jePodezreleVysoka =
      nejvyssiPlatnaHodnota > 0 &&
      hodnota > nejvyssiPlatnaHodnota + ODO_MAX_SKOK_MEZI_BUNKAMI_M;
    if (jePodezreleVysoka) continue;
    if (hodnota >= nejvyssiPlatnaHodnota)
    { nejvyssiPlatnaHodnota = hodnota;
      adresaSNejvyssiHodnotou = adr;}
  }
  odoMetry = nejvyssiPlatnaHodnota;
  odoAdresaAktualni = adresaSNejvyssiHodnotou;}

bool ulozOdoDoEEPROM(unsigned long hodnotaMetru){
  #if KONTROLA_NAPETI_ZAPNUTA
  posledniZmereneVccMv = nactiNapetiVcc(); // změřit jednou, uložit, a použít i na displej
  if (posledniZmereneVccMv < MIN_VCC_PRO_ZAPIS_MV){ 
    nizkeNapeti = true; // >>> tečka se rozsvítí
    #ifdef DEBUG_MODE
    eepromNapetiPocet++; // >>> DEBUG - nezapsalo se kvůli napětí
    #endif
    return false; }
#endif
  odoAdresaAktualni += 4;
  if (odoAdresaAktualni > ODO_ADR_KONEC)
  { odoAdresaAktualni = ODO_ADR_START;}
  EEPROM.put(odoAdresaAktualni, hodnotaMetru);
  return true;}

// --- TRIP a MAX RPM přežívajou reset (detekce sraček v RAM) ---
const unsigned long TRIP_MAGIC = 0xA5C3F00DUL;  // platná RAM = pokračuj, jinak nuluj


// ============================================================
// 5) PŘERUŠENÍ - SPEEDO
// ============================================================

void snimacSpeedoPreruseni()
{ unsigned long ted = micros();

  if (speedoIsrCasPoslednihoPulzuUs == 0)
  { speedoIsrCasPoslednihoPulzuUs = ted;
    return;}

  unsigned long interval = ted - speedoIsrCasPoslednihoPulzuUs;

    // Kratší pulzy zahazujem rovnou v ISR jako rušení.
  if (interval < MIN_MEZERA_PULZU_US)
  {    return;}

  speedoIsrDelkaPoslednihoIntervaluUs = interval;
  speedoIsrCasPoslednihoPulzuUs = ted;
  speedoIsrMameNovyPulz = true;}

// ============================================================
// 6) PŘERUŠENÍ - TACHO
// ============================================================

void snimacTachoPreruseni()
{ unsigned long ted = micros();
  if (tachoIsrCasPoslednihoPulzuUs == 0)
  { tachoIsrCasPoslednihoPulzuUs = ted;
    return;}
  unsigned long interval = ted - tachoIsrCasPoslednihoPulzuUs;

    // Bordel od zapalování - pokud je pulz moc brzo, ignorujem ho.
  if (interval < MIN_MEZERA_TACHO_US)
  { return;}

  tachoIsrDelkaPoslednihoIntervaluUs = interval;
  tachoIsrCasPoslednihoPulzuUs = ted;
  tachoIsrMameNovyPulz = true;}

// ============================================================
// 7) FILTR SPEEDA
// ============================================================

float vyhladRychlost(float noveMereniKmh)
{ kalman_p = kalman_p + KALMAN_Q;
  float zisk = kalman_p / (kalman_p + KALMAN_R);
  kalman_x = kalman_x + zisk * (noveMereniKmh - kalman_x);
  kalman_p = (1.0 - zisk) * kalman_p;
  return kalman_x;}

// "ted" je čas (z micros()) tohodle pulzu - potřeba pro
// fyzikální kontrolu rychlosti změny.
bool jePulzSpeedaDuveryhodny(float surovaRychlostKmh, unsigned long ted)
{ bool vysledek = true;

  if (surovaRychlostKmh > MAX_ROZUMNA_RYCHLOST_KMH)
  { vysledek = false;}

  if (vysledek && jsmeVPohybu)
  { float rozdilOdVyhlazene = fabs(surovaRychlostKmh - kalman_x);

    if (rozdilOdVyhlazene > MAX_SKOK_KMH)
    { bool souhlasiSPredchozim =
        mamePredchoziPulz &&
        fabs(surovaRychlostKmh - posledniSurovaRychlostKmh)
          < MAX_ROZDIL_SOUSEDNICH_PULZU_KMH;

      // Fyzikální kontrola: i kdyby dva pulzy souhlasily,
      // implikovaná rychlost změny nesmí přesáhnout to, co
      // moped fyzicky dokáže. Periodické rušení dokáže
      // "souhlasit samo se sebou", ale nedokáže obelhat čas.
      float uplynuleSekundy =
        (ted - casPoslednihoZpracovanehoPulzuUs) / 1000000.0;

      bool jeZmenaFyzikalneMozna =
        uplynuleSekundy > 0 &&
        (rozdilOdVyhlazene / uplynuleSekundy) <= MAX_ZMENA_RYCHLOSTI_KMH_ZA_S;

      if (souhlasiSPredchozim && jeZmenaFyzikalneMozna) // Dva pulzy si sedí a je to možné -> reálné zrychlení.
      { kalman_x = surovaRychlostKmh; 
        kalman_p = 1.0; }
      else { vysledek = false; }
    }}
  return vysledek;
}

// ============================================================
// 8) FILTR TACHA
// ============================================================

float vyhladRpm(float noveMereniRpm)
{ tachoKalman_p = tachoKalman_p + TACHO_KALMAN_Q;
  float zisk = tachoKalman_p / (tachoKalman_p + TACHO_KALMAN_R);
  tachoKalman_x = tachoKalman_x + zisk * (noveMereniRpm - tachoKalman_x);
  tachoKalman_p = (1.0 - zisk) * tachoKalman_p;
  return tachoKalman_x;
}

bool jePulzTachaDuveryhodny(float suroveRpm)
{ if (suroveRpm > MAX_ROZUMNE_RPM ||
      suroveRpm < MIN_ROZUMNE_RPM)
  { return false;}

  if (motorBezi)
  { float rozdil = fabs(suroveRpm - tachoKalman_x);

    if (rozdil > MAX_SKOK_RPM)
    { bool souhlasiSPredchozim =
        tachoMamePredchoziPulz &&
        fabs(suroveRpm - posledniSuroveRpm)
          < MAX_ROZDIL_SOUSEDNICH_PULZU_RPM;

      if (souhlasiSPredchozim) // Dva pulzy po sobě sedí -> motor fakt změnil otáčky.
      { tachoKalman_x = suroveRpm;
        tachoKalman_p = 1.0;
      } else { return false;}
    }}
  return true;}


// ============================================================
// 9A) HEARTBEAT LED (diagnostické blikání LED D13)
// ============================================================

// Timer2 -> jeden "tik" cca 16 ms.
// V ISR čeká 16 tiků (~256 ms), než LED přepne. Běží nezávisle na loop().

void nastavHeartbeatTimer()
{ pinMode(13, OUTPUT);
  TCCR2A = (1 << WGM21);                              // CTC mód
  TCCR2B = (1 << CS22) | (1 << CS21) | (1 << CS20);   // prescaler 1024
  OCR2A = 249;                                         // perioda ~16 ms
  TIMSK2 = (1 << OCIE2A);                              // povolit přerušení
}

ISR(TIMER2_COMPA_vect)
{ heartbeatPocitadloPreruseni++;
  if (heartbeatPocitadloPreruseni >= 16)   // ~16 x 16 ms ≈ 256 ms
  { heartbeatPocitadloPreruseni = 0;
    digitalWrite(13, !digitalRead(13));  }
}

// ============================================================
// 9B) ÚVODNÍ LOGO
// ============================================================

void zobrazUvodniLogo()
{ pinMode(13, OUTPUT);

  const int VYSKA_OBLASTI_LOGA = 50;
  int x = (128 - STADION_WIDTH) / 2;
  int y = (VYSKA_OBLASTI_LOGA - STADION_HEIGHT) / 2;

  // Page buffer: kreslení se opakuje pro každou část displeje.
  u8g2.firstPage();
  do
  { u8g2.drawXBMP(x, y, STADION_WIDTH, STADION_HEIGHT, logo_stadion);
    u8g2.setFont(u8g2_font_5x7_tf);
    u8g2.setCursor(0, 64);
    u8g2.print((__FlashStringHelper*)FW_VERZE); 
    #ifdef DEBUG_MODE
    u8g2.print(F(" D"));   // debug build
    #endif
    }
  while (u8g2.nextPage());

  const unsigned long krokMs =
    LOGO_DOBA_ZOBRAZENI_MS / (LOGO_POCET_BLIKNUTI * 2);

  for (byte i = 0; i < LOGO_POCET_BLIKNUTI; i++)
  { digitalWrite(13, HIGH);
    delay(krokMs);
    digitalWrite(13, LOW);
    delay(krokMs); }
}

// ============================================================
// 9C) I2C BUS CLEAR
// ============================================================

// I2C FIX: zvon na hajzl pro I2C. aka defibrilátor = kurva důležité.

void i2cBusClearPokudJeZaseknuto()
{
  pinMode(SDA, INPUT_PULLUP);
  pinMode(SCL, INPUT_PULLUP);
  delayMicroseconds(10);

  bool byloZaseknute = (digitalRead(SDA) == LOW);
  if (byloZaseknute) {
    // 9 hodinových pulzů
    for (int i = 0; i < 9; i++) {
      if (digitalRead(SDA) == HIGH) break; // Displej už pustil SDA, můžeme se na to vyjebat
      pinMode(SCL, OUTPUT);
      digitalWrite(SCL, LOW);
      delayMicroseconds(5);
      pinMode(SCL, INPUT_PULLUP);
      delayMicroseconds(5);
    }

    // STOP podmínka - VŽDY, když jsme dělali clearing
    pinMode(SCL, OUTPUT);
    digitalWrite(SCL, LOW);       // SCL = LOW
    delayMicroseconds(5);
    pinMode(SDA, OUTPUT);
    digitalWrite(SDA, LOW);       // SDA = LOW
    delayMicroseconds(5);
    pinMode(SCL, INPUT_PULLUP);   // SCL jde HIGH
    delayMicroseconds(5);
    pinMode(SDA, INPUT_PULLUP);   // SDA LOW->HIGH při SCL=HIGH = STOP
    delayMicroseconds(5);
  }

  // Resume do běžného I2C režimu
  pinMode(SDA, INPUT_PULLUP);
  pinMode(SCL, INPUT_PULLUP);
}

// Start I2C od nuly: uvolnit piny, vyklepat sběrnici, nahodit Wire s timeoutem a displej.
// Volá se při startu i po timeoutu za běhu.
void i2cStart()
{
  Wire.end();                          // bez tohohle bit-bang na pinech nic nehne
  i2cBusClearPokudJeZaseknuto();
  Wire.setWireTimeout(I2C_TIMEOUT_US, true);    // 10 ms, při timeoutu resetni TWI hardware
  u8g2.begin();
  Wire.clearWireTimeoutFlag();         // begin() na mrtvém displeji mohl nastavit flag
}

void vykresliDashboardBezpecne()
{ vykresliDashboard();
  if (Wire.getWireTimeoutFlag()) {
    #ifdef DEBUG_MODE
    i2cTimeoutPocet++;
    #endif
    i2cStart();
  }
}


// ============================================================
// 10) HLAVNÍ SMYČKA - SETUP
// ============================================================

void setup()

{ // Po resetu watchdogem by mohl zůstat běžet s krátkým limitem.
  MCUSR = 0;
  wdt_disable();
  wdt_enable(WDTO_8S);

// I2C FIX
i2cBusClearPokudJeZaseknuto();

  u8g2.begin();

  i2cStart();   // I2C FIX

  // Speedo: D2 / INT0.
  pinMode(SENSOR_PIN, INPUT_PULLUP);

  // Tacho: D3 / INT1.
  pinMode(TACHO_PIN, INPUT_PULLUP);

  // Magic number nesedí = studený start (v RAM je bordel).
  // Sedí = reset za jízdy, TRIP a TOP zůstávají.
  bool studenyStart = (tripMagic != TRIP_MAGIC);
  if (studenyStart)
  { tripMetry = 0;
    topRychlostKmh = 0;
    topRpm = 0;
    tripMagic = TRIP_MAGIC;

    zobrazUvodniLogo();     // logo jen při studeném startu
  }

// DEBUG MODE počítadlo I2C bus clearů a resetů
#ifdef DEBUG_MODE
  if (studenyStart)
  { resetPocet = 0;
    i2cTimeoutPocet = 0;
    eepromNapetiPocet = 0;}              // noinit = po studeném startu vynulovat
  else
  { resetPocet++; }                      // RAM přežila = byl to reset, ne zapnutí
#endif
  
  // Heartbeat běží od teď dál, nezávisle na zbytku programu.
  nastavHeartbeatTimer();

  nactiOdoZEEPROM();
  odoNaposledyUlozeno = odoMetry;

  // Přerušení pro kolo.
  attachInterrupt(digitalPinToInterrupt(SENSOR_PIN), snimacSpeedoPreruseni, FALLING);

  // Přerušení pro otáčky motoru.
  attachInterrupt(digitalPinToInterrupt(TACHO_PIN), snimacTachoPreruseni, FALLING);

  vykresliDashboard();

  // Přezbrojení na přísný 2s watchdog PRO BĚŽNÝ PROVOZ
  wdt_enable(WDTO_2S);
}

// ============================================================
// 11) ZPRACOVÁNÍ SPEEDA
// ============================================================

void zpracujNovySpeedoPulzPokudExistuje()
{ if (!speedoIsrMameNovyPulz)
  { return; }

  unsigned long intervalUs;

  noInterrupts();
  intervalUs = speedoIsrDelkaPoslednihoIntervaluUs;
  speedoIsrMameNovyPulz = false;
  interrupts();

  const float MS_PER_HODINU = 3600000.0;

  float surovaRychlostKmh =
    (OBVOD_KOLA_M * MS_PER_HODINU) / intervalUs;

  unsigned long ted = micros();

  bool duveryhodny = jePulzSpeedaDuveryhodny(surovaRychlostKmh, ted);

  // Bez ohledu na výsledek si VŽDYCKY zapamatujeme surovou
  // hodnotu a čas - i zamítnutý pulz je platný referenční bod
  // pro porovnání s tím příštím. Bez tohohle by jediné zamítnutí
  // při prudkém zrychlení zpřetrhalo řetězec navždy (dokud
  // nezastavíš) - přesně tohle způsobovalo zaseknutí na
  // konstantní špatné rychlosti po prudkém rozjezdu.
  posledniSurovaRychlostKmh = surovaRychlostKmh;
  mamePredchoziPulz = true;
  casPoslednihoZpracovanehoPulzuUs = ted;

  if (!duveryhodny)
  { return; }

  jsmeVPohybu = true;

  float vyhlazenaKmh = vyhladRychlost(surovaRychlostKmh);
  zobrazenaRychlostKmh =
    (unsigned int)(vyhlazenaKmh + 0.5);

  //TOP SPEED
  if (zobrazenaRychlostKmh > topRychlostKmh)
  { topRychlostKmh = zobrazenaRychlostKmh; }

  // Akumulace zlomkových metrů.
  static float zbytekMetruAkumulator = 0.0;
  zbytekMetruAkumulator += OBVOD_KOLA_M;
  if (zbytekMetruAkumulator >= 1.0)
  {    unsigned long celeMetry =
      (unsigned long)zbytekMetruAkumulator;
    odoMetry += celeMetry;
    tripMetry += celeMetry;
    zbytekMetruAkumulator -= celeMetry;
  }

  // EEPROM zápis po 100 m.
  if (odoMetry - odoNaposledyUlozeno >= KROK_ULOZENI_M)
  { if (ulozOdoDoEEPROM(odoMetry))
    { odoNaposledyUlozeno = odoMetry; }}
}

// ============================================================
// 12) ZPRACOVÁNÍ TACHA
// ============================================================

void zpracujNovyTachoPulzPokudExistuje()
{ if (!tachoIsrMameNovyPulz)
  { return; }

  unsigned long intervalUs;

  noInterrupts();
  intervalUs = tachoIsrDelkaPoslednihoIntervaluUs;
  tachoIsrMameNovyPulz = false;
  interrupts();

  // 1 pulz = 1 otáčka / PULZY_NA_OTACKU.
  // 60 000 000 us za minutu / perioda / pulzy_na_otacku = RPM.
  float suroveRpm =
    (60000000.0 / intervalUs) / PULZY_NA_OTACKU;

  if (!jePulzTachaDuveryhodny(suroveRpm))
  {tachoMamePredchoziPulz = false; return;}

  tachoMamePredchoziPulz = true;
  posledniSuroveRpm = suroveRpm;
  motorBezi = true;

  float vyhlazeneRpm = vyhladRpm(suroveRpm);
  zobrazeneRpm = (unsigned int)(vyhlazeneRpm + 0.5);

  if (zobrazeneRpm > topRpm)
  { topRpm = zobrazeneRpm; }
}

// ============================================================
// 13) KONTROLA ZASTAVENÍ SPEEDA
// ============================================================

void zkontrolujJestliStojimeSpeedo()
{
  unsigned long casPoslednihoPulzu;

  noInterrupts();
  casPoslednihoPulzu = speedoIsrCasPoslednihoPulzuUs;
  interrupts();

  bool jsmeUzNekdyJeli =
    (casPoslednihoPulzu != 0);

  unsigned long dobaBezPulzuUs =
    micros() - casPoslednihoPulzu;

  if (jsmeUzNekdyJeli && dobaBezPulzuUs > CAS_DO_ZASTAVENI_MS * 1000UL)
  {
    kalman_x = 0;
    kalman_p = 1;
    zobrazenaRychlostKmh = 0;
    mamePredchoziPulz = false;
    jsmeVPohybu = false;
  }
}

// ============================================================
// 14) KONTROLA ZASTAVENÍ TACHA
// ============================================================

void zkontrolujJestliStojimeTacho()
{
  unsigned long casPoslednihoPulzu;

  noInterrupts();
  casPoslednihoPulzu =
    tachoIsrCasPoslednihoPulzuUs;
  interrupts();

  bool mameAsponJedenPulz =
    (casPoslednihoPulzu != 0);

  unsigned long dobaBezPulzuUs =
    micros() - casPoslednihoPulzu;

  if (mameAsponJedenPulz &&
      dobaBezPulzuUs >
        CAS_DO_ZASTAVENI_TACHO_MS * 1000UL)
  {
    tachoKalman_x = 0;
    tachoKalman_p = 1;
    zobrazeneRpm = 0;
    tachoMamePredchoziPulz = false;
    motorBezi = false;
  }
}

// ============================================================
// 15) LOOP
// ============================================================

void loop()
{
  // if (millis() > 1999UL) { while (1); }   // TEST WATCHDOG WDT - resetuje furt dokola

  // Watchdog krmíme pravidelně, jinak MCU udělá reset.
  wdt_reset();

  zpracujNovySpeedoPulzPokudExistuje();
  zpracujNovyTachoPulzPokudExistuje();

  zkontrolujJestliStojimeSpeedo();
  zkontrolujJestliStojimeTacho();

  unsigned long ted = millis();

  if (ted - displejNaposledyCas > DISPLEJ_INTERVAL_MS)
  {
    
    vykresliDashboardBezpecne();
    displejNaposledyCas = ted;
  }
}

// ============================================================
// 16) DISPLEJ
// ============================================================


// Ikonka TOP 5x7: (šipka nahoru)
const uint8_t IKONA_TOP[] PROGMEM = {
  0xff, 0xe4, 0xee, 0xff, 0xe4, 0xe4, 0xe4
};

void vykresliDashboard()
{
  // --------------------------------------------------------
  // 16.1) VÝPOČTY A LOGIKA REŽIMŮ (PŘED KRESLENÍM)
  // --------------------------------------------------------
  // Kreslení v page bufferu se opakuje (u "_2_" 4x), takže uvnitř smyčky
  // má být jen kreslení, nic jiného.
  // --------------------------------------------------------

  // Aplikace násobiče pro testovací účely
  unsigned int testRpm = zobrazeneRpm * TEST_MULTIPLIER;
  unsigned int testRychlost = zobrazenaRychlostKmh * TEST_MULTIPLIER;

  // Hystereze a logika přepínání do Režimu Otáčkoměru (Rev Mode)
  if (odoMetry < 100 && testRpm > 0)     // kdyz ma budik najeto 0km, ukazujem tacho.
  {rezimOtackomeru = true;}
  else if (topRychlostKmh == 0 && testRpm > 0)   // túrujem na místě ale ještě jsme nevyjeli: budík je tacho
  {rezimOtackomeru = true;}
  else if (testRychlost == 0 && testRpm >= 5000)  // tůrujem po jízdě, ukazujem tacho.
  {rezimOtackomeru = true;} 
  else if (testRychlost > 0 || testRpm < 2400)  // dotůrovali jsme.
  {rezimOtackomeru = false;}

  // RPM ve stovkách (8000 RPM = 80)
  unsigned int rpmStovky = testRpm / 100;

  // TRIP KM celé+desetiny (2.3km)- příprava proměnných pro celý scope
  char tripText[16] = "";
  int sirkaTripu = 0;
  if (tripMetry > 0){
  unsigned long tripDesetiny = tripMetry / 100UL;
  snprintf(tripText, sizeof(tripText), "t %lu.%lu", tripDesetiny / 10, tripDesetiny % 10);}
  
  // Šířka pro zarovnání doprava (font musí být nastavený před getStrWidth)
  u8g2.setFont(u8g2_font_6x10_tf);
  sirkaTripu = u8g2.getStrWidth(tripText);


  // --------------------------------------------------------
  // 16.2) KRESLENÍ
  // --------------------------------------------------------
  
  u8g2.firstPage(); do {
    
    if (rezimOtackomeru)
    {
      // ====================================================
      // 16.3) TACHO aka RevMode
      // ====================================================
     
      u8g2.setFont(u8g2_font_logisoso42_tn);
      unsigned int tisiceRpm = testRpm / 1000;
      unsigned int stovkyZbytekRpm = testRpm % 1000;

      if (testRpm < 1000) 
      { if (testRpm < 10)       { u8g2.setCursor(50, 45); }
        else if (testRpm < 100) { u8g2.setCursor(33, 45); }
        else                    { u8g2.setCursor(20, 45); }
        u8g2.print(testRpm);}
      else {
        int RpmStartX = (tisiceRpm >= 10) ? -14 : 0;
        u8g2.setCursor(RpmStartX, 45);
        u8g2.print(tisiceRpm);
        // Mezera 10px mezi tisíci a stovkami
        int xKurzor = u8g2.getCursorX() + 10; 
        u8g2.setCursor(xKurzor, 45);
        if (stovkyZbytekRpm < 10)       { u8g2.print(F("00")); }
        else if (stovkyZbytekRpm < 100) { u8g2.print('0'); }
        u8g2.print(stovkyZbytekRpm);
      }

      u8g2.setFont(u8g2_font_6x10_tf);
      u8g2.setCursor(0, 64);
      u8g2.print(F("RPM"));

      if (topRpm != 0)   // TOP RPM
      { u8g2.drawXBMP(26, 57, 5, 7, IKONA_TOP);
        u8g2.setCursor(35, 64);
        u8g2.print(topRpm * TEST_MULTIPLIER);}

      if (tripMetry > 100) // TRIP v otáčkoměru
      { u8g2.setCursor(128 - sirkaTripu, 64);
        u8g2.print(tripText);
      }
    }else{

      
      // ====================================================
      // 16.4) LAYOUT B: SPÍDO
      // ====================================================


    // ----------------------------------------------------
    // RPM vpravo nahoře (ve stovkách RPM). Zobrazí se pokud nějaké otáčky čteme
    // ----------------------------------------------------
    
    if (testRpm != 0){
      u8g2.setFont(u8g2_font_logisoso24_tn);
      if (rpmStovky < 100) { u8g2.setCursor(99, 31); }  // dvoumístné
      else                 { u8g2.setCursor(85, 31); }  // třímístné
      if (rpmStovky < 10)  { u8g2.print('0'); }         // vodicí nula
      u8g2.print(rpmStovky);
    }

    // ----------------------------------------------------
    // Velké číslo rychlosti.
    // ----------------------------------------------------
    
    u8g2.setFont(u8g2_font_logisoso58_tn);

    if (testRychlost < 10)       { u8g2.setCursor(37, 58); }  // (x,y)
    else if (testRychlost < 100) { u8g2.setCursor(6, 58); }
    else                         { u8g2.setCursor(-20, 58); }
    u8g2.print(testRychlost);


    // ----------------------------------------------------
    // TOP SPEED (jen když stojíme a něco už se zaznamenalo).
    // ----------------------------------------------------
    
    if (testRychlost == 0 && topRychlostKmh != 0)
    { if (testRpm == 0) { u8g2.drawXBMP(98, 17, 5, 7, IKONA_TOP); }  // (šipka nahoru; x,y,w,h)
      else              { u8g2.drawXBMP(0, 10, 5, 7, IKONA_TOP); }

      u8g2.setFont(u8g2_font_6x10_tf);
      if (testRpm == 0) { u8g2.setCursor(106, 24); }
      else              { u8g2.setCursor(7, 17); }
      u8g2.print(topRychlostKmh * TEST_MULTIPLIER);
    }

    // ----------------------------------------------------
    // Drobné nápisy: TRIP, km/h, rpm, ODO
    // ----------------------------------------------------

    // DEBUG Diagnostika: počítadlo závad
    #ifdef DEBUG_MODE
    if (i2cTimeoutPocet > 0 || resetPocet > 0 || eepromNapetiPocet > 0) {
    u8g2.setFont(u8g2_font_5x7_tf);
    u8g2.setCursor(30, 64);
    u8g2.print(F("I2C")); u8g2.print(i2cTimeoutPocet);  // timeouty zotavené bez resetu
    u8g2.print(F(" R"));  u8g2.print(resetPocet);       // resety za provozu
    u8g2.print(F(" E"));  u8g2.print(eepromNapetiPocet);// EEPROM low voltage ochrana
    u8g2.setCursor(0, 6);
    if (posledniZmereneVccMv > 0) {
    u8g2.print(F(" ")); u8g2.print(posledniZmereneVccMv / 1000);
    u8g2.print(F(".")); u8g2.print((posledniZmereneVccMv % 1000) / 100);
    u8g2.print(F("V"));}}
    #endif

    // Low Voltage Flag - Hnědý poplach: tečka po neúspěšném zápisu do eeprom
    if (nizkeNapeti) {
    u8g2.drawPixel(0, 0);
    }

    
    u8g2.setFont(u8g2_font_6x10_tf);

    // TRIP, zarovnaný doprava
    //_______________________________________
    if (tripMetry > 90) {
    u8g2.setCursor(128 - sirkaTripu, 64);
    u8g2.print(tripText);}

    // Popisek km/h, jen když nečteme RPM
    //_______________________________________
    if (testRpm == 0)
    { u8g2.setCursor(98, 36);
      u8g2.print(F("km/h"));}

    // Při pomalé jízdě: popisek rpm a ODO km
    //_______________________________________
    if (testRychlost <= 19)
    { if (testRpm != 0)
      { u8g2.setCursor(103, 41);
        u8g2.print(F("rpm"));}
      if (odoMetry >= 900) // pokud už jsme nějaké zaznamenali
      { u8g2.setCursor(0, 64);
        u8g2.print(odoMetry / 1000);}}}
        
  }while (u8g2.nextPage());
}
