davidkerny/Stadi_Speedo/Stadi_ThermoGauge/teplomer.h

// Kostra teploměru 16x44 - předělej si v editoru (XBM, LSB first).
#define TEPLOMER_WIDTH 16
#define TEPLOMER_HEIGHT 30
const uint8_t ikona_teplomer[] PROGMEM = {

 0x80,0x01,0xc0,0x03,0xc0,0x03,0xc0,0x02,0xc0,0x0e,0xc0,0x0e,
 0xc0,0x02,0xc0,0x02,0xc0,0x02,0xc0,0x0e,0xc8,0x0e,0xc0,0x02,
 0xc0,0x02,0xd0,0x02,0xc1,0x0e,0xc0,0x0e,0xc8,0x02,0xc0,0x02,
 0xd2,0x03,0xc8,0x03,0xe0,0x27,0xf0,0x0f,0xf0,0x0f,0xf8,0x1f,
 0xf8,0x17,0xf8,0x13,0xf8,0x19,0xf0,0x08,0x70,0x0e,0xc0,0x03


};
