davidkerny/Stadi_Speedo/(commit log)

2026-06-30 Initial V2 Stadi Speedo
    [Stadion_rychlomer.kicad_pcb, Stadion_rychlomer.kicad_sch]
2026-07-01 Fixed labels, added filtering caps, modified rpm sense
    [Stadion_rychlomer.kicad_sch]
2026-07-02 Round PCB V1
    [Stadion_rychlomer.kicad_pcb, Stadion_rychlomer.kicad_sch, stadi speedo board holes layout.dxf]
2026-07-06 SPD Optocoupler ESD Protection
    [Stadion_rychlomer.kicad_pcb, Stadion_rychlomer.kicad_sch]
2026-07-08 Ferrite beads add
    [Stadion_rychlomer-B_Cu.gbr, Stadion_rychlomer-B_Mask.gbr, Stadion_rychlomer-B_Paste.gbr, Stadion_rychlomer-B_Silkscreen.gbr, Stadion_rychlomer-Edge_Cuts.gbr, Stadion_rychlomer-F_Cu.gbr, Stadion_rychlomer-F_Mask.gbr, Stadion_rychlomer-F_Paste.gbr]
2026-08-13 Ordered in JLCPCB
    Added GND Ferrite bead
    Ordered in JLCPCB - stadisped.zip
    [Stadion_rychlomer.kicad_pcb, Stadion_rychlomer.kicad_sch, stadisped_bom.csv, stadisped_designators.csv, stadisped_positions.csv]
2026-08-26 Update Silkprint a drobná škatulata
    [Stadion_rychlomer.kicad_pcb, Stadion_rychlomer.kicad_sch]
2026-08-28 Updated PNs, minor tweaks on PCB
    [Stadion_rychlomer.kicad_pcb, Stadion_rychlomer.kicad_sch]
2026-09-11 SCL SDA Fixed, minor edits
    [Stadion_rychlomer.kicad_pcb, Stadion_rychlomer.kicad_sch]
2026-09-11 Speedo V6 (eeprom brownout corruption prevention)
    [Stadi_Speedo.ino]
2026-09-24 add Stepper Tester
2026-09-25 add I2C bus clear function with earlier watchdog
2026-10-04 fix TVS na VIN
    [Stadion_rychlomer.kicad_pcb]
2026-10-06 Revise README with hardware variant information
    Updated README to include details about variants for different hardware boards.
2026-10-07 Speedo Uni PCB V2 Initial
    [Stadi_Speedo_V2-B_Cu.gbr, Stadi_Speedo_V2-B_Mask.gbr, Stadi_Speedo_V2-B_Paste.gbr, Stadi_Speedo_V2-B_Silkscreen.gbr, Stadi_Speedo_V2-Edge_Cuts.gbr, Stadi_Speedo_V2-F_Cu.gbr, Stadi_Speedo_V2-F_Mask.gbr, Stadi_Speedo_V2-F_Paste.gbr]
2026-10-07 update pcb V2
    [Stadi_Speedo_V2.kicad_pcb]
2026-10-07 PCB V2 Update
    [Stadi_Speedo_V2.kicad_pcb, Stadi_Speedo_V2.kicad_sch]
2026-10-08 PCB Stadi Uniface
    [Stadi_Speedo_V2.kicad_pcb, UniFace.kicad_pcb, UniFace.kicad_sch]
2026-10-08 UniFace PCB
2026-10-21 BUCK KONVERTER ADD
2026-10-22 pridany ferity na termistor a 5V
2026-10-26 small tune a gerbers, Výroba!!!
2026-11-02 updated Component Values and PNs
    little better BOM
2026-11-07 MultiGauge V2.0 I2C FIX a DEBUG!!
2026-11-07 v2.1: I2CFix, Hnědý poplach, zobrazení vcc
2026-11-07 I2C TIMEOUT FIX REVOLUCE, hnědý poplach atd
2026-11-08 AnaloGauge 2.2 I2C Fixer a rychlé Recovery po resetu
